tscircuit/rack-actuator/README.md

# Rack actuator

A 3D-printable rack-and-pinion linear actuator with **NEMA17 or NEMA14 drive**, **six 625ZZ guide bearings**, compliant rack teeth, and an enclosure with M3 heat-set mounting inserts. Choose **40, 100 or 150 mm stroke**, with an enclosed rack or a shorter rear pass-through housing.

**[Open the interactive CAD viewer](https://flex17-compliant-linear-actuator.seveibar.chatgpt.site/)** · **[Try the shorter enclosure](https://flex17-compliant-linear-actuator.seveibar.chatgpt.site/?motor=nema17&stroke=40&enclosure=pass-through)** · **[Explore NEMA14](https://flex17-compliant-linear-actuator.seveibar.chatgpt.site/?motor=nema14&stroke=40&enclosure=enclosed)** · **[Download CAD](https://flex17-compliant-linear-actuator.seveibar.chatgpt.site/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)**

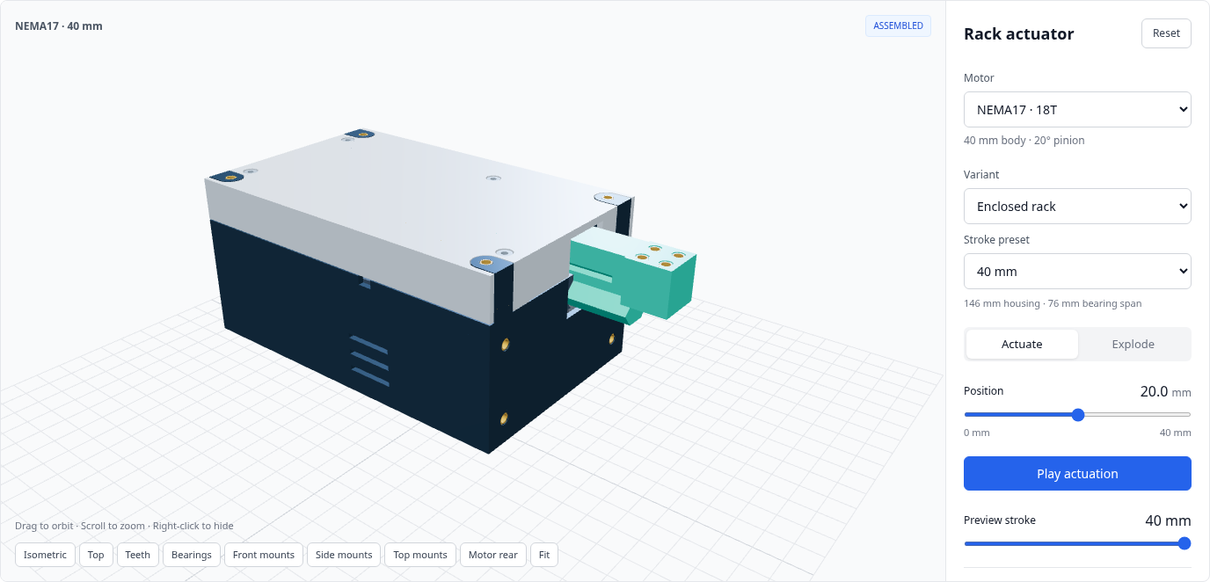
[picture p1: docs/images/viewer-overview.png]
NEMA17 actuator in the interactive viewer, with motor, enclosure variant, stroke and actuation controls (https://flex17-compliant-linear-actuator.seveibar.chatgpt.site/?motor=nema17&stroke=40&enclosure=enclosed)


The viewer provides actuation, a staged exploded assembly, right-click part hiding, mounting views, a resolution table, and preset-specific STEP/STL downloads. Screenshots and dimensions below show **CAD revision 24 at tooth module 2**. Click a screenshot to open its preset. Links select the motor, stroke and enclosure; camera angles, hidden parts and explosion stages are controlled inside the viewer.

[Models](#choose-a-model) · [Mechanism](#how-the-mechanism-works) · [Mounting](#mounting-the-module-and-its-load) · [Hardware & printing](#hardware-and-printing) · [Assembly](#assembly-and-service) · [Resolution](#resolution) · [Customize](#download-and-customize) · [Validation](#validation-and-practical-limits)

## Experimental worm drive

A separate **NEMA17 / NEMA14 worm family** is available at **40, 100 and 150 mm stroke** in the [worm viewer](https://flex17-compliant-linear-actuator.seveibar.chatgpt.site/experiments/worm-rack/). The worm now fits directly on the unchanged motor shaft position. A lowered tooth strip on a ribbed rack spine eliminates both spur gears and one worm bearing. The remaining end support uses an M5 insert and bolt through a captured 625ZZ bearing.

The **flat enclosure has the same dimensions, mounting-hole coordinates and mounting planes as the matching fully enclosed spur preset**. The worm contacts the underside of its matched compliant rack, retaining the guide profile and output mount. The motor body projects through the rear for back-face/controller access; its projection is listed separately in the viewer. These remain unprinted prototypes. See the [preset details, assembly sequence, source and checks](experiments/worm-rack/README.md). All twelve spur presets and both worm tooth styles use the axial NEMA17 output plate.

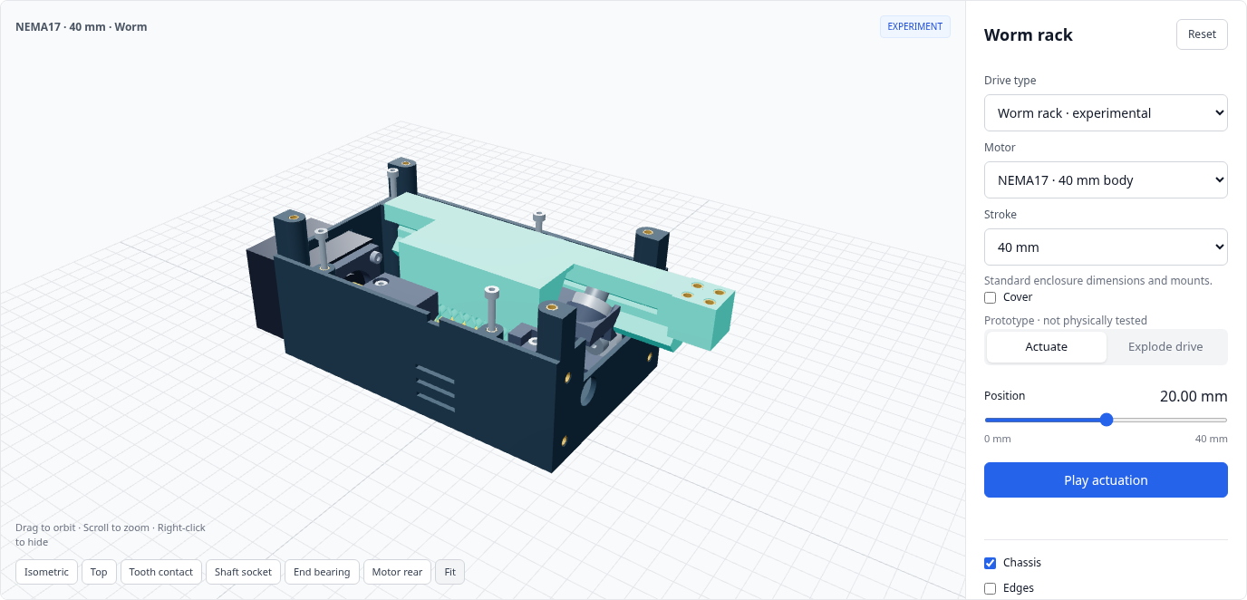
[picture p2: docs/images/worm-overview.png]
Enclosed NEMA17 40 mm worm-drive prototype with compatible mounting interfaces (https://flex17-compliant-linear-actuator.seveibar.chatgpt.site/experiments/worm-rack/)


## Lead-screw experiments

Both lead-screw families use a hollow carriage, two bearing stations and one four-bolt adjustable lower bearing carrier. The 40 mm printed-screw stroke supports 1×, 2× and 4× output widths. The 120 mm printed-screw stroke and both T8 lengths are 1× only. All have individual STL downloads and an exploded assembly.

- [Printed Ø20 mm screw](https://flex17-compliant-linear-actuator.seveibar.chatgpt.site/experiments/printed-leadscrew/?travel=120): select **40 or 120 mm travel**. Two threaded carriage bands stay engaged throughout travel, with the screw contained inside the retracted carriage. [Build details](experiments/printed-leadscrew/README.md).
- [T8×8 screw](https://flex17-compliant-linear-actuator.seveibar.chatgpt.site/experiments/t8-leadscrew/): select **100 or 300 mm purchased screw length**, providing 70 or 230 mm standard-drive travel. The 100 mm rod offers 1×/2×/4× widths. A selectable **6805 Z-axis support** uses a captured second brass nut and provides 44 / 204 mm travel for 100 / 300 mm rods. The 300 mm models have 80 mm between guide-bearing stations. [Build details](experiments/t8-leadscrew/README.md).

Both have windowed lids and a uniform 31 mm mounting grid on the output plate, lid and base. Output widths are 42/104/168 mm; the 2× plate is wider to retain a centered NEMA17 square. Both base and lid grids extend the same 31 mm alignment toward their exit edges. The 120 mm printed-screw version has 16 base and 14 lid insert seats; the 300 mm T8 has 22 on each face. Short versions retain 10/20/30 seats per face for 1×/2×/4× widths. Rounded side and floor windows are applied after all features. A single coordinated pattern preserves at least 6 mm between neighboring windows and protects the motor foot, bearing supports, adjustment shelves and mounting seats. Wider plates can mount along the host length: all eight 2× holes, or at least ten of twelve 4× holes in either of two offset positions. Longer grids also support the forward outer pair, allowing all twelve holes in the forward position. These external mounts use **short Ø4.6 × 4 mm M3 heat-set inserts**, with Ø4 mm printed pilots. Lid seats pass through; base seats below structural feet retain backing. Install lid inserts from above and base inserts from below. External side mounting bosses and holes have been removed. The shared lower carrier still uses four M5 inserts. Its support blocks rise just 1 mm above the Z=20 mm side rails with 1 mm, 45-degree top chamfers, remaining 3.5 mm below the original tall bumps; the bearing seats, split axles and mounting positions are retained. The fixed bearing supports extend down to Z=28 mm, flush with the adjustment-bolt shelves, filling the former 4 mm recess. Print fit and structural performance require physical testing.

## Choose a model

### Independent 6805 bearing support

The [6805 support prototype](https://flex17-compliant-linear-actuator.seveibar.chatgpt.site/experiments/bearing-supported-screw/) assembles a NEMA17, a flat 4 mm wall, an open bearing holder and the existing 40 mm-travel printed screw with an added bearing ring. Revision 3 keeps the 30.3 mm projection and motor-facing bearing recess, adding four exposed mounting flanges and side windows for loading the M3 screws. The 31 mm NEMA17 pattern and existing screw lengths are retained. The screw passes through the bearing and holder from the motor side, with its shoulder contacting the inner race. There is no separate cap, circlip or spacer. This supports thrust toward the screw tip; reverse retention relies on the coupling. Existing actuator geometry is unchanged. The viewer includes a section, corrected staged explosion and three printable STLs. [Build notes](dist/experiments/bearing-supported-screw/README.txt), [CAD source](experiments/bearing-supported-screw/model.py) and [assembly checks](experiments/bearing-supported-screw/check_assembly.py) cover fits and sampled clearances; PETG creep and vibration retention require physical testing.

All twelve combinations are generated and available to view and download:

| Motor | Stroke | Enclosed rack | Rear pass-through |
| --- | --- | --- | --- |
| NEMA17 | 40 mm | [View / download](https://flex17-compliant-linear-actuator.seveibar.chatgpt.site/?motor=nema17&stroke=40&enclosure=enclosed) | [View / download](https://flex17-compliant-linear-actuator.seveibar.chatgpt.site/?motor=nema17&stroke=40&enclosure=pass-through) |
| NEMA17 | 100 mm | [View / download](https://flex17-compliant-linear-actuator.seveibar.chatgpt.site/?motor=nema17&stroke=100&enclosure=enclosed) | [View / download](https://flex17-compliant-linear-actuator.seveibar.chatgpt.site/?motor=nema17&stroke=100&enclosure=pass-through) |
| NEMA17 | 150 mm | [View / download](https://flex17-compliant-linear-actuator.seveibar.chatgpt.site/?motor=nema17&stroke=150&enclosure=enclosed) | [View / download](https://flex17-compliant-linear-actuator.seveibar.chatgpt.site/?motor=nema17&stroke=150&enclosure=pass-through) |
| NEMA14 | 40 mm | [View / download](https://flex17-compliant-linear-actuator.seveibar.chatgpt.site/?motor=nema14&stroke=40&enclosure=enclosed) | [View / download](https://flex17-compliant-linear-actuator.seveibar.chatgpt.site/?motor=nema14&stroke=40&enclosure=pass-through) |
| NEMA14 | 100 mm | [View / download](https://flex17-compliant-linear-actuator.seveibar.chatgpt.site/?motor=nema14&stroke=100&enclosure=enclosed) | [View / download](https://flex17-compliant-linear-actuator.seveibar.chatgpt.site/?motor=nema14&stroke=100&enclosure=pass-through) |
| NEMA14 | 150 mm | [View / download](https://flex17-compliant-linear-actuator.seveibar.chatgpt.site/?motor=nema14&stroke=150&enclosure=enclosed) | [View / download](https://flex17-compliant-linear-actuator.seveibar.chatgpt.site/?motor=nema14&stroke=150&enclosure=pass-through) |

### Enclosure options

**Enclosed rack** keeps the toothed section inside the housing throughout normal travel; the smooth output tongue extends through the front. **Rear pass-through** removes the rear storage chamber and adds an opening for the rack and teeth. Both retain the same motor position, bearing stations, rack and usable stroke.

| Stroke | Enclosed housing length | Pass-through housing length | Length saved | Maximum rear projection |
| --- | --- | --- | --- | --- |
| 40 mm | 146 mm | 125 mm | 21 mm | 17 mm |
| 100 mm | 256 mm | 175 mm | 81 mm | 77 mm |
| 150 mm | 356 mm | 225 mm | 131 mm | 127 mm |

Housing width is **90.8 mm for NEMA17** and **84.8 mm for NEMA14**. The shorter housing still needs clearance for the rack's full swept travel. At module 2, its rear opening spans Y=15…41 mm and Z=−10…22 mm in CAD coordinates.

The following two screenshots use the **same 150 mm pass-through model and camera**, first fully retracted, then fully extended:

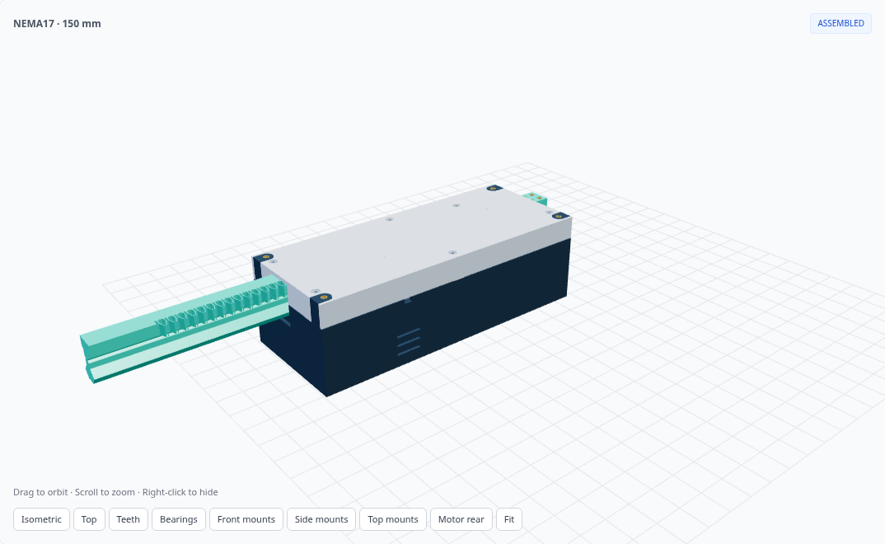
[picture p3: docs/images/pass-through-retracted.png]
150 mm pass-through actuator fully retracted, with the rack projecting through the rear of its 225 mm housing (https://flex17-compliant-linear-actuator.seveibar.chatgpt.site/?motor=nema17&stroke=150&enclosure=pass-through)


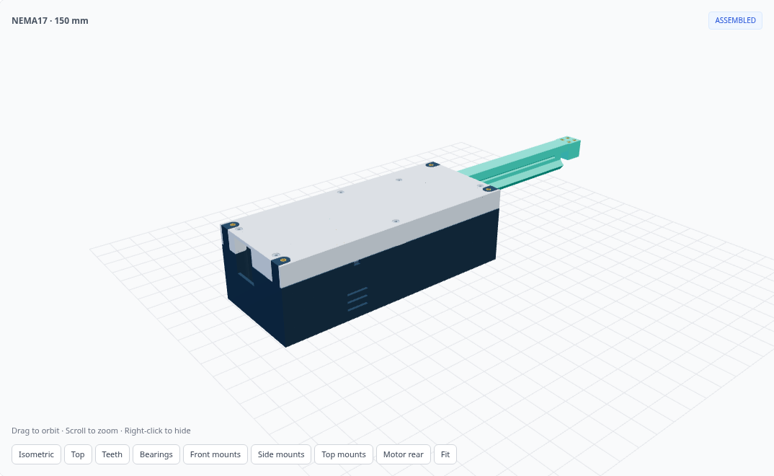
[picture p4: docs/images/pass-through-extended.png]
The same 150 mm pass-through actuator fully extended, with the output now projecting from the front (https://flex17-compliant-linear-actuator.seveibar.chatgpt.site/?motor=nema17&stroke=150&enclosure=pass-through)


[Try the 150 mm pass-through model](https://flex17-compliant-linear-actuator.seveibar.chatgpt.site/?motor=nema17&stroke=150&enclosure=pass-through) and drag **Position** between 0 and 150 mm, or select **Play actuation**.

Use the complete bundle for the selected motor, stroke and enclosure. Tray, lid, mounting coordinates and chassis clearance slots can differ between variants.

### NEMA17 versus NEMA14

| Default | NEMA17 | NEMA14 |
| --- | --- | --- |
| Reference motor body | 42 × 42 × 40 mm | 35.2 × 35.2 × 34 mm |
| Motor mounting pitch | 31 mm | 26 mm |
| Pinion | 18 teeth, 20° pressure angle | 14 teeth, 25° pressure angle |
| Tooth module | 2 mm | 2 mm |
| Travel per revolution | 113.097 mm | 87.965 mm |
| Housing width | 90.8 mm | 84.8 mm |

These are full-depth reference motors. The rear-mounted controller can remain outside the enclosure; its exact dimensions are not modeled. Verify the shaft, pilot and mounting dimensions of the motor you plan to use. The NEMA14 pinion gives a smaller commanded travel increment; motor torque and achievable accuracy depend on the actual hardware.

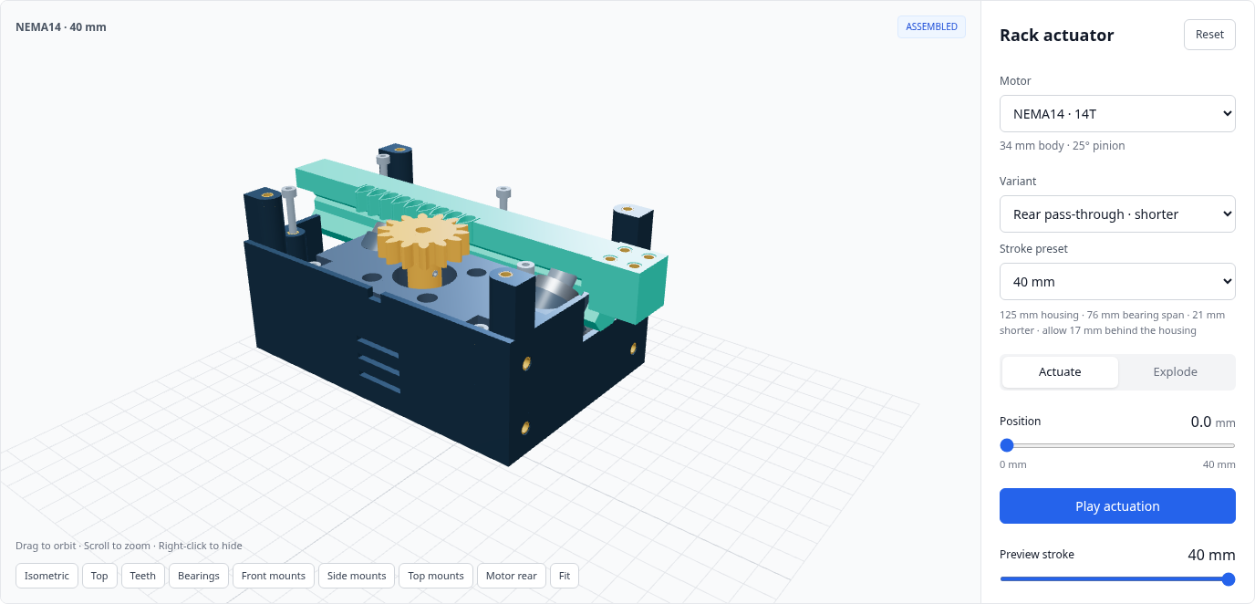
[picture p5: docs/images/nema14-viewer.png]
NEMA14 40 mm pass-through actuator with its cover hidden to reveal the smaller pinion and bearing mechanism (https://flex17-compliant-linear-actuator.seveibar.chatgpt.site/?motor=nema14&stroke=40&enclosure=pass-through)


## How the mechanism works

The pinion drives a compliant rack guided by two sets of three bearings. The chassis incorporates the motor mounting land and lower-bearing flexures. Five printed parts make up the module: **chassis, rack, pinion, tray and lid**.

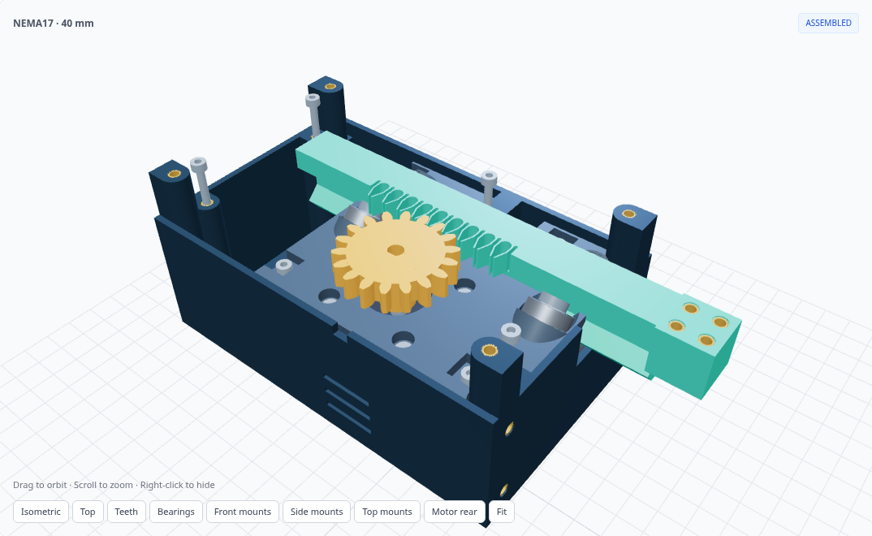
[picture p6: docs/images/mechanism.png]
NEMA17 actuator with the lid hidden, showing the pinion, compliant rack, bearing stations and chassis mounting screws (https://flex17-compliant-linear-actuator.seveibar.chatgpt.site/?motor=nema17&stroke=40&enclosure=enclosed)


### Compliant rack teeth

The rack teeth are oversized by **0.10 mm per flank** by default, so the flexible tooth walls preload the mesh. Circular reliefs blend tangentially into the slots, avoiding sharp internal corners where the teeth bend. There are no separate internal tooth fingers. The defaults use 0.60 mm walls and an 8 mm tooth face.

The design is intended to reduce backlash through elastic contact. It does not establish a measured backlash, force or fatigue rating. Tooth size is configurable through `--tooth-module`.

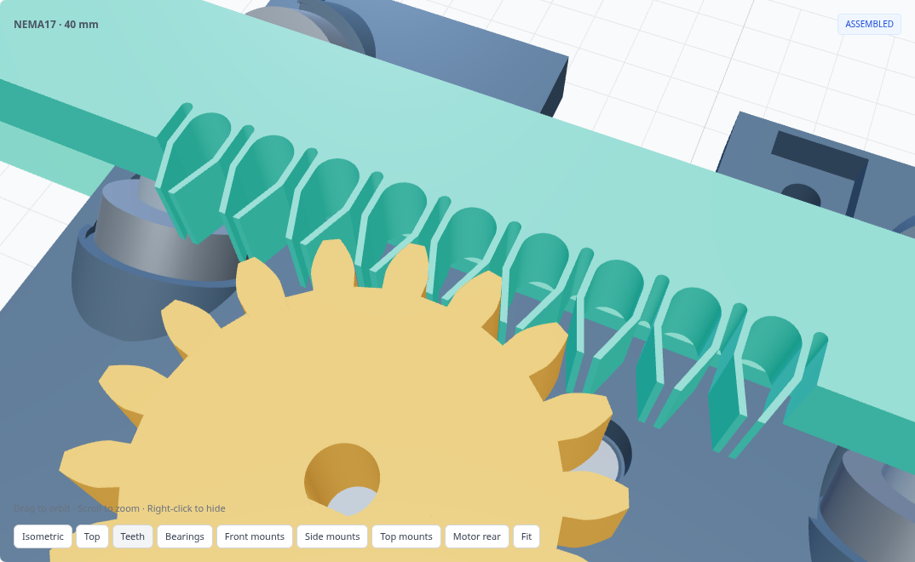
[picture p7: docs/images/compliant-teeth.png]
Close view of the pinion meshing with oversized compliant rack teeth and rounded relief cuts (https://flex17-compliant-linear-actuator.seveibar.chatgpt.site/?motor=nema17&stroke=40&enclosure=enclosed)


[Inspect the teeth in 3D](https://flex17-compliant-linear-actuator.seveibar.chatgpt.site/?motor=nema17&stroke=40&enclosure=enclosed) using the **Teeth** view. The tooth concept is inspired by [seveibar/compliant-spur-gear](https://github.com/seveibar/compliant-spur-gear).

### Bearing guidance and integral flexures

All six guide bearings are **625ZZ, 5 × 16 × 5 mm**. Four upper bearings sit at 45°; two lower bearings press upward from integral flexure floors. Recesses in the rack provide vertical support. The bearing layout constrains the rack while allowing translation along its travel axis.

The lower flexure is a single broad floor with a **14 mm free span**, **1.8 mm default thickness**, supported R1.2 wall blends and **2.3 mm nominal installed deflection**. The STL chassis is relaxed; the STEP assembly and viewer show the installed shape. CAD deformation is prescribed, not a calculated load/deflection curve.

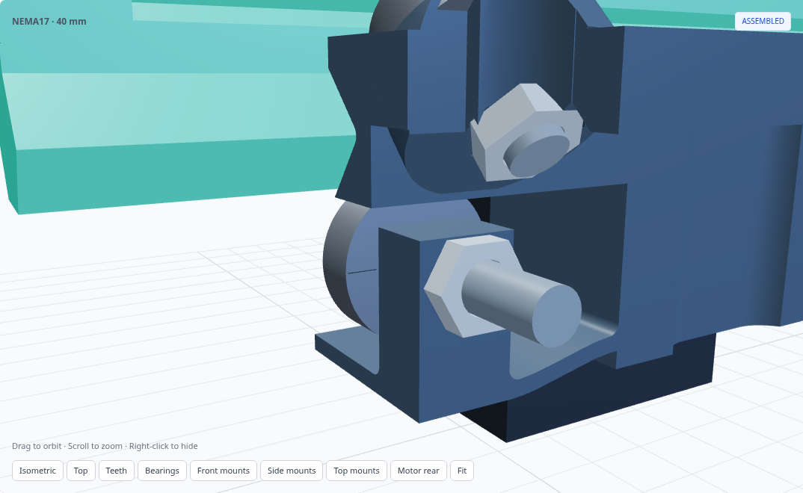
[picture p8: docs/images/bearing-flexure.png]
Close view of a bearing station, axle hardware and the integral lower-bearing flexure floor (https://flex17-compliant-linear-actuator.seveibar.chatgpt.site/?motor=nema17&stroke=40&enclosure=enclosed)


The motor stays at X=0 and the rear bearing station at X=−32 mm. The exit station is **13 mm behind the front face**, placing the bearing rim 5 mm behind the opening. The pinion is offset toward the rear bearing group.

| Stroke | Bearing station centers X | Bearing span | Rack print length |
| --- | --- | --- | --- |
| 40 mm | −32, 44 mm | 76 mm | 161.5 mm |
| 100 mm | −32, 94 mm | 126 mm | 271.5 mm |
| 150 mm | −32, 144 mm | 176 mm | 371.5 mm |

Nominal rack/chassis clearance is 1 mm. Bearing relief defaults to 0.8 mm and axle-head relief to 0.5 mm. Check actual printed and purchased hardware clearances; clamp bearing inner races without clamping the rotating outer races.

## Mounting the module and its load

M3 heat-set inserts default to **4.6 mm OD × 5 mm long**, with **4.2 mm printed pilot holes**. Qualify the pilot and installation temperature for your particular inserts and print material. Four inserts are provided on each of the following mounting faces:

| Face | Mounting pattern | Insert position |
| --- | --- | --- |
| Front / rack exit (+X) | Housing width − 18 mm by motor depth − 10 mm | 0.3 mm recessed |
| Side (+Y) | Housing length − 15 mm by motor depth − 10 mm | 0.3 mm recessed |
| Top (+Z) | Housing length − 15 mm by housing width − 15 mm | Flush in full-height tray posts |
| Moving output (+X, along travel) | NEMA17: 31 × 31 mm on a 42 × 42 × 8 mm end plate | 0.3 mm recessed |

The output pad is centered on the rack backbone. Its four insert pockets continue as **3.4 mm through-holes through the full 8 mm plate**. Either fit M3 inserts or skip them and use M3 through-bolts with washers and nuts. Choose bolt length for the pad, attachment, washers and nut engagement. Use application-length screws with **3–5 mm insert engagement**: 3.3–5.3 mm penetration from recessed faces, or 3–5 mm from the flush top face. Use the selected preset's mounting metadata to lay out your fixture.

The fixed front face has four inserts outside the rack opening. A front fixture must clear the moving guide and the entire output pad at full retraction. At module 2, the minimum rectangular fixture opening spans the preset’s `frontFixtureOpeningYZ` metadata, including the end plate. Top fixtures load the full-height tray posts; remove them before opening the lid.

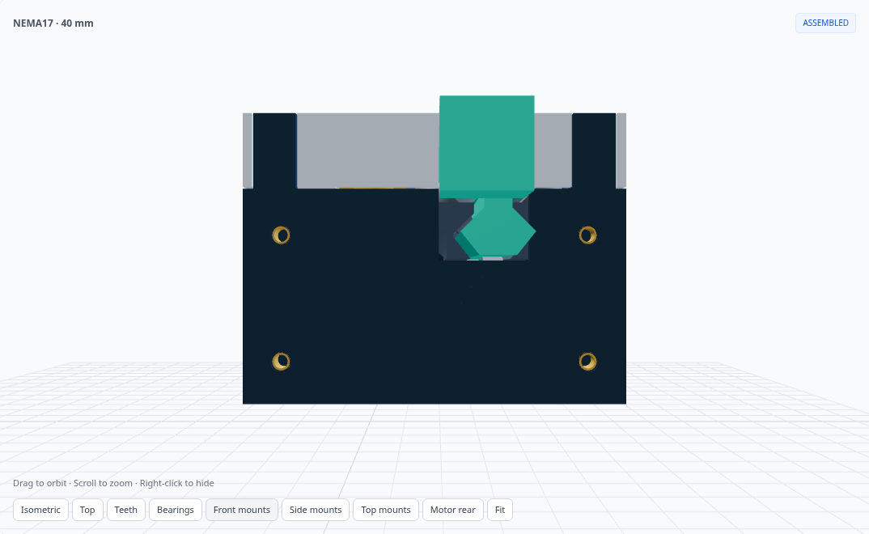
[picture p9: docs/images/front-mounts.png]
Front view of the enclosure mounting inserts and the moving rack output (https://flex17-compliant-linear-actuator.seveibar.chatgpt.site/?motor=nema17&stroke=40&enclosure=enclosed)


[Open the mounting views](https://flex17-compliant-linear-actuator.seveibar.chatgpt.site/?motor=nema17&stroke=40&enclosure=enclosed) and select **Front mounts**, **Side mounts** or **Top mounts**.

### Motor and driver access

The motor mounting land is integral to the chassis. The pinion has a **5.30 mm D bore** for a nominal 5 mm shaft with a 0.5 mm-deep flat. Its M3×4 flat-point set screw acts normal to the shaft flat; tap the 2.5 mm pilot M3.

The motor rear projects 4 mm beyond the housing. Leave room behind it for the driver, wiring, cooling and removal. The screenshot shows the reference motor, not a modeled controller board.

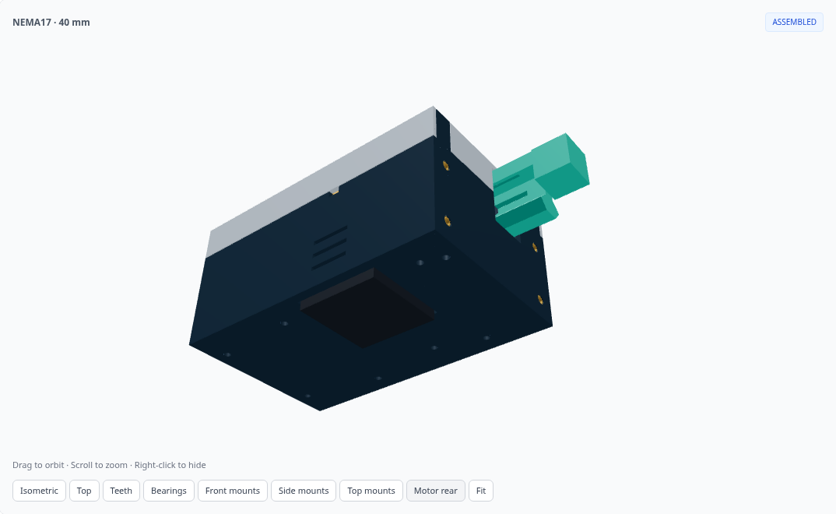
[picture p10: docs/images/motor-rear.png]
View beneath the enclosure showing the exposed rear of the reference motor and clearance for a rear-mounted driver (https://flex17-compliant-linear-actuator.seveibar.chatgpt.site/?motor=nema17&stroke=40&enclosure=enclosed)


## Hardware and printing

Every download bundle contains a preset-specific `bill-of-materials.json` and `configuration.json`.

| Common hardware | Quantity / specification |
| --- | --- |
| Stepper motor | 1 × matching NEMA17 or NEMA14 motor |
| Guide bearings | 6 × 625ZZ, 5 × 16 × 5 mm |
| Upper bearing axles | 4 × M5×16 socket screws |
| Lower bearing axles | 2 × M5×25 socket screws |
| Bearing nuts | 6 × thin M5 nuts, modeled 2.7 mm thick |
| Inner-race washers | 6 × 0.3 mm thick, 7.5 mm OD |
| Motor screws | 4 × M3×12 countersunk |
| Pinion set screw | 1 × M3×4 flat point |
| Lid screws | M3×20 socket; quantity below |
| Chassis screws | Front M3×10 / rear M3×16 socket; quantities below |
| External mounting screws | Application-specific lengths; observe insert engagement |

| Stroke / enclosure | Total M3 inserts, including output | Lid screws | Front / rear chassis screws |
| --- | --- | --- | --- |
| 40 mm, either enclosure | 24 | 4 | 2 / 2 |
| 100 mm, enclosed | 28 | 6 | 3 / 3 |
| 100 mm, pass-through | 26 | 4 | 3 / 3 |
| 150 mm, either enclosure | 28 | 6 | 3 / 3 |

Rear chassis inserts sit **6 mm below the standoff tops**, clearing the neighboring M5 hardware. Use the specified M3×16 rear screws; the front screws are M3×10.

| Printed part | Orientation / important detail |
| --- | --- |
| Chassis | Y normal to the bed, keeping the XZ flexure bending plane within the layers; use local supports at passages where needed |
| Rack | End plate projects past both long faces; use supports beneath the rack, or print on the plate if build height and layer strength permit. Keep tooth reliefs clear. |
| Pinion | Gear face down; finish the set-screw pilot with an M3 tap |
| Tray | Outer floor down |
| Lid | Roof down |

Parts are single-piece. Check your printer's build volume, especially the 271.5 and 371.5 mm racks. A shorter enclosure does not shorten the printed rack. See [printing and assembly instructions](README.txt) for insert depths, clearances and the detailed assembly sequence.

## Assembly and service

[Open the assembly viewer](https://flex17-compliant-linear-actuator.seveibar.chatgpt.site/?motor=nema17&stroke=40&enclosure=enclosed) and select **Explode**. The slider separates components in stages, including lifting and parking axle hardware and moving the chassis before lowering the tray.

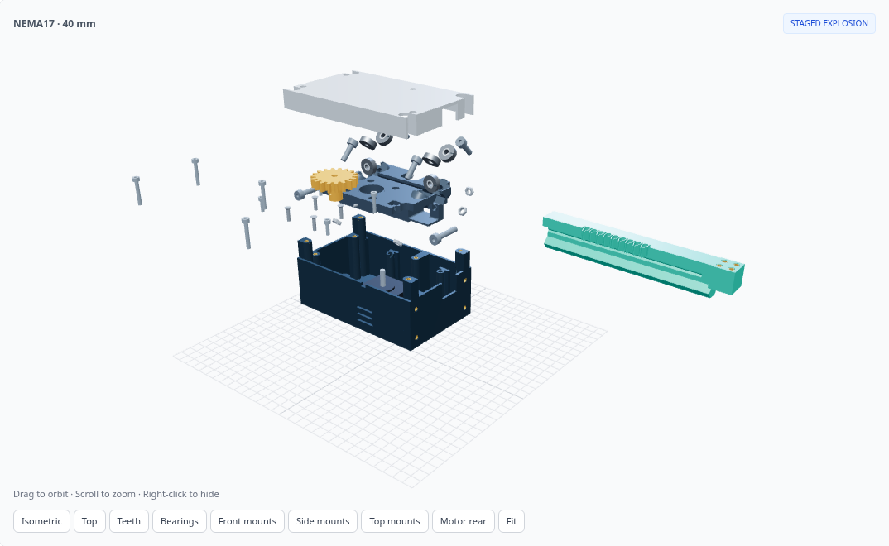
[picture p11: docs/images/exploded-assembly.png]
Exploded actuator showing the rack, enclosure, chassis, bearings and fasteners along staged clearance paths (https://flex17-compliant-linear-actuator.seveibar.chatgpt.site/?motor=nema17&stroke=40&enclosure=enclosed)


A practical assembly outline:

1. Print and clean the five parts. Clear tooth reliefs and bearing pockets; prepare the pinion's set-screw thread.
2. Install the tray heat-set inserts and, if using them, the output-pad inserts before closing access to their pockets.
3. Fit the lower bearings with their axles backed out 10 mm and nuts held loose. Start the chassis 6 mm above and 10 mm behind its seated position, slide it forward, lower it, then advance the axles and tighten the nuts.
4. Install the front and rear chassis screws. Fit the motor and motor screws before the upper rollers and axles.
5. Fit the pinion and set screw. Insert the rack from the output side, square end first, with the motor free to turn; support the spring seats as needed.
6. Confirm all six bearings turn without rubbing, fit the lid, then attach the external fixture and load. Check full travel at low speed before applying load.

For service, remove external fixtures and load first. Follow the exploded sequence: lid and rack, pinion, upper axle hardware and rollers, motor, chassis screws, partial lower-axle withdrawal, chassis lift/slide, tray, then the remaining bearing hardware. The animation illustrates clearance paths; it does not model gravity or workholding. [README.txt](README.txt) gives the complete sequence.

## Resolution

For a 1.8° motor with 200 full steps per revolution:

```text
travel per command = π × tooth module × pinion tooth count / (200 × microstep factor)
```

| Setting | NEMA17, 18T: mm/command | NEMA14, 14T: mm/command |
| --- | --- | --- |
| Full step | 0.565487 | 0.439823 |
| Half step | 0.282743 | 0.219911 |
| 1/4 step | 0.141372 | 0.109956 |
| 1/8 step | 0.070686 | 0.054978 |
| 1/16 step | 0.035343 | 0.027489 |

These are nominal command increments, not measured positioning accuracy. Stroke and enclosure choice do not change the drive ratio. Match the calculation to the actual motor's full-step angle.

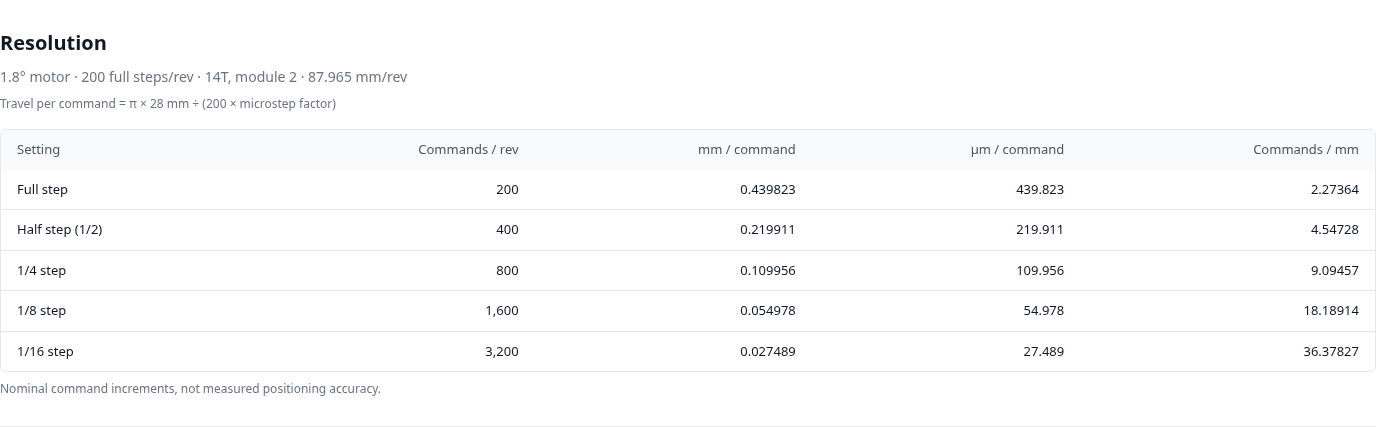
[picture p12: docs/images/resolution.png]
NEMA14 resolution table in the viewer showing full, half, quarter, eighth and sixteenth-step command increments (https://flex17-compliant-linear-actuator.seveibar.chatgpt.site/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)


[View the NEMA17 resolution table](https://flex17-compliant-linear-actuator.seveibar.chatgpt.site/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) · [View the NEMA14 resolution table](https://flex17-compliant-linear-actuator.seveibar.chatgpt.site/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)

## Download and customize

The easiest route is to [open the site](https://flex17-compliant-linear-actuator.seveibar.chatgpt.site/), choose **Motor**, **Variant** and **Stroke preset**, then use **Downloads → CAD bundle**. Each bundle includes:

- Five printable STL parts. STEP export is currently omitted from the hosted bundles.
- Parametric CadQuery source and the selected configuration.
- Hardware quantities, printing/assembly instructions and licenses.
- Collision, guide and service-clearance reports.

The **Configure** panel exports JSON parameters or a CadQuery command. Tooth module, stroke, housing length and motor body depth are separate parameters. The viewer displays generated module-2 presets; custom values require regeneration.

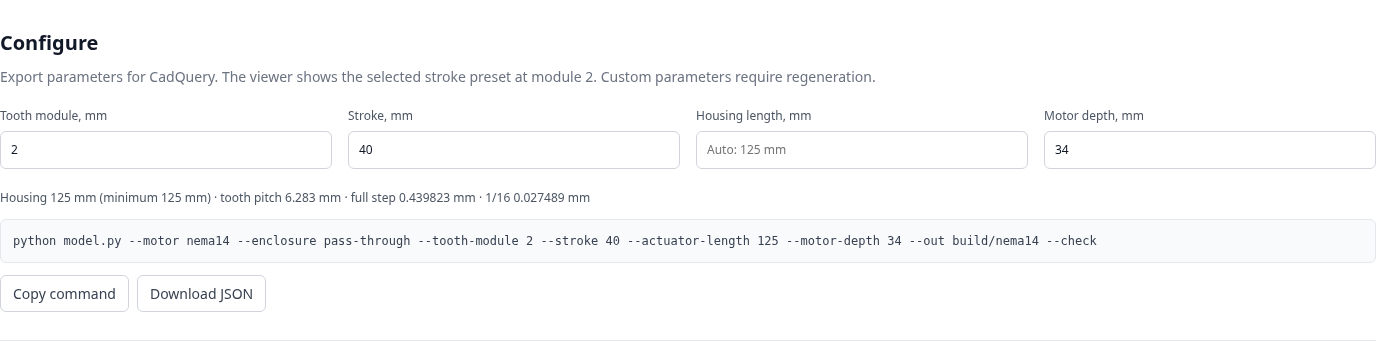
[picture p13: docs/images/configuration.png]
Configuration panel for tooth module, stroke, housing length and motor depth, with JSON export and a CadQuery command (https://flex17-compliant-linear-actuator.seveibar.chatgpt.site/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)


[Open the configurator](https://flex17-compliant-linear-actuator.seveibar.chatgpt.site/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) · [NEMA17 downloads](https://flex17-compliant-linear-actuator.seveibar.chatgpt.site/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) · [NEMA14 downloads](https://flex17-compliant-linear-actuator.seveibar.chatgpt.site/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)

### Run the viewer locally

The generated models are committed, so previewing them does not require CadQuery:

```sh
git clone https://github.com/tscircuit/rack-actuator.git
cd rack-actuator
python -m http.server 8000 --directory dist
```

Open `http://localhost:8000`. Use an HTTP server rather than opening `index.html` directly, because the viewer loads model files with `fetch`.

### Generate a custom actuator

Use Python 3.12 and CadQuery 2.7.0:

```sh
pip install -r requirements.txt

# Example: NEMA14, 100 mm stroke, shorter rear pass-through housing
python model.py --motor nema14 --stroke 100 --enclosure pass-through --out build/custom --check

# Or use the configuration exported by the site / included in a bundle
python model.py --config path/to/configuration.json --out build/custom --check
```

Explicit CLI arguments override JSON values. Housing length defaults to the calculated minimum for the selected stroke, tooth size and enclosure. The CLI name for housing length is `--actuator-length`.

| Parameter | Supported values / default |
| --- | --- |
| `--motor` | `nema17` (default) or `nema14` |
| `--enclosure` | `enclosed` (default) or `pass-through` |
| `--stroke` | 20–150 mm; default 40 |
| `--tooth-module` | 1.5–2.5 mm; default 2 |
| `--actuator-length` | Calculated minimum through 2000 mm |
| `--motor-depth` | 32–60 mm; defaults 40 / 34 for NEMA17 / NEMA14 |
| `--insert-od`, `--insert-length`, `--insert-pilot` | Defaults 4.6 / 5 / 4.2 mm |
| `--spring-preload` | 0.1–2.5 mm; default 2.3 |
| `--spring-thickness` | 1.6–2.2 mm; default 1.8 |
| `--bearing-clearance`, `--hardware-clearance` | Defaults 0.8 / 0.5 mm |
| `--rack-backbone-width` | 14.5–18 mm; default 16 |
| `--preload` | Tooth oversize per flank; default 0.10 mm |

Regenerate, check and package all twelve presets from the repository root:

```sh
python build_presets.py --jobs 4
python check_flexure_service.py --jobs 4
python check_lid_screw_parking.py --all
python package_designs.py
```

The axial NEMA17 output update replaces only the former mounting pad. Exact solid differences confirm unchanged guide and tooth geometry. Continuous conservative swept bounds check the larger plate through full travel and every assembly translation stage; previous mechanism checks are retained with their original report hashes. New output-hole and insertion-access probes and watertight STL checks accompany each preset. The interface is the four-hole NEMA17 pattern; no motor pilot or shaft bore is added.

Build caching is tied to source, motor, stroke and enclosure. Use a distinct output directory for custom models to keep the supplied presets intact.

## Validation and practical limits

The supplied presets have completed sampled travel, explosion and service checks with no unexpected intersections. The reports distinguish intentional elastic tooth contact and heat-set insert interference from unwanted solid intersections.

| Report / check | What it covers |
| --- | --- |
| `validation.json` | Assembled part pairs; 41 travel positions; guide contacts; nominal tooth mesh; insert access, annular backing and output through-holes; flexure/hardware clearances; staged explosion |
| `flexure-service-validation.json` | Bearing and enclosure service paths from 38–100% explosion, with translation increments at most 0.5 mm |
| `lid-screw-clearance.json` | Continuous swept envelopes for removing lid screws and separating them from subsequent assembly motion |
| `check_guide_constraints.py` | Bearing guidance constraints |

Enclosure/fastener paths are sampled at no more than 0.5 mm translation increments. Core explosion checks include 1% slider intervals, stage boundaries/midpoints and bearing-release transitions. Reports record source hashes and explain any retained results where geometry and checking logic are unchanged.

These checks do not replace a physical tolerance, side-load or fatigue test. The flexure's restoring force, recovery and lifetime have not been rated; the compliant teeth have no measured backlash/load rating. There is no axial hard stop or downward flexure stop. Use controller travel limits and validate the print material and actual hardware before loading the module.

[Open validation reports on the site](https://flex17-compliant-linear-actuator.seveibar.chatgpt.site/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) · [Detailed assembly instructions](README.txt)

## Repository map

| Path | Contents |
| --- | --- |
| [model.py](model.py) | Parametric CadQuery geometry, exports and checks |
| [build_presets.py](build_presets.py) | Generates the two motors × three strokes × two enclosures |
| [package_designs.py](package_designs.py) | Packages downloads and creates the preset manifest |
| [check_flexure_service.py](check_flexure_service.py) | Dense bearing-removal/service checks |
| [check_lid_screw_parking.py](check_lid_screw_parking.py) | Lid-screw clearance proof |
| [dist/](dist/) | Static viewer, generated meshes and CAD downloads |
| [dist/presets.json](dist/presets.json) | Paths and metadata for all twelve presets |
| [README.txt](README.txt) | Detailed printing, insert installation and assembly instructions |
| [docs/images/](docs/images/) | Screenshots of the revision 24 viewer and mechanism |

## License and credits

MIT; see [LICENSE](LICENSE). The compliant tooth principle is inspired by [seveibar/compliant-spur-gear](https://github.com/seveibar/compliant-spur-gear). Its license is included in the CAD bundles.

For Site packaging after regenerating spur presets, run `python scripts/prune-bundled-stls.py`. It verifies loose STL files against the existing ZIP bundles before removing duplicate payloads; individual viewer downloads extract the same STL bytes from those bundles.

All six supported lead-screw configurations are rebuilt and checked with the bundled generator and validator. Reports retain their exact SHA-256 hashes. Checks cover the full bearing sweep, motion and assembly clearance, insert access, mounting grids, preserved base supports and connected printable solids.

Lead-screw bearing axles use tapered, rounded-root relief slots and clearance behind the inner-race seats. The retained 6.4 mm heads and extended 30° tips are unchanged. Assembly checks distinguish undeformed head contact from unexpected collisions; physical snap force and fatigue remain unmeasured.

The lead-screw bases use filled motor feet, 45-degree side-window roofs and bottom access below the adjustment shelves. Inspect the actual 40 mm, 1x printed-screw base slice at [the support preview](https://flex17-compliant-linear-actuator.seveibar.chatgpt.site/experiments/printed-leadscrew/slice/). Reproduction profiles and G-code extraction are in `experiments/printed-leadscrew/slicing/`.

The 1x T8 and printed-screw output plates have two underside openings for fitting the lower M3 mounting bolts from inside. Fully extend the carriage for access. The front 31 mm pattern, 8 mm flange thickness and bearing tracks are retained. Use the viewer’s **Bolt access** view to inspect them.

The 2×/4× printed-screw plates now have bolt-access openings for every repeated output pattern. The front bearing station moves inward 14 mm to protect the full rolling surfaces (60 mm between stations); overall size and 40 mm extension are unchanged. Use the updated wide base, carrier, lid and carriage together. The previously published 1× geometry and example base slice are unchanged.

The two lid mounts beside the motor now grow from continuous gussets, rooted 2 mm into the motor wall. Their undersides slope at least 45° above horizontal in both the forward and outward directions, replacing the hanging blocks and thin tabs. The existing lid holes and 68 mm assembly height are retained; only the base STL changes for this revision. Print with the base floor on the bed. The public slice preview uses the updated 40 mm, 1× printed-screw base.
