tscircuit/rack-actuator/docs/images/output-mount.png

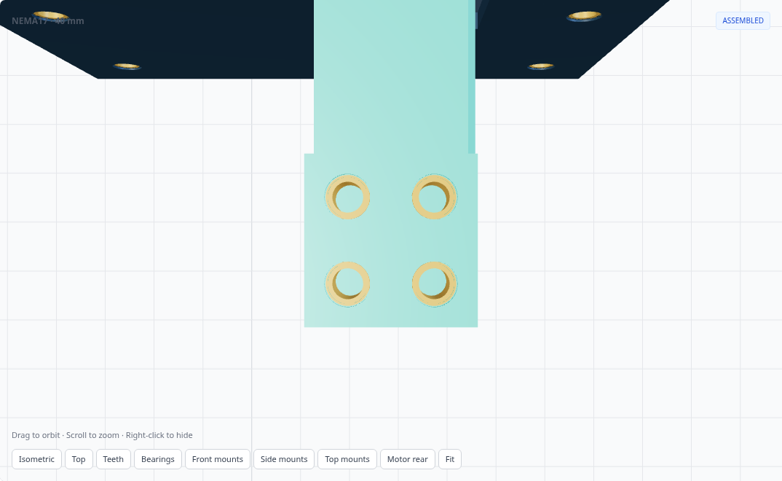
docs/images/output-mount.png
