tscircuit/rack-actuator/docs/images/output-through-holes.png

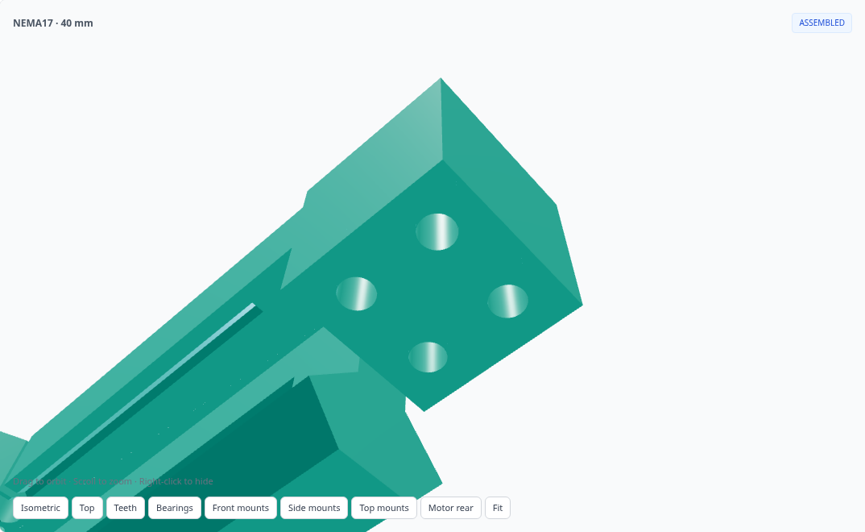
docs/images/output-through-holes.png
