tscircuit/rack-actuator/docs/images/worm-nema14-150.png

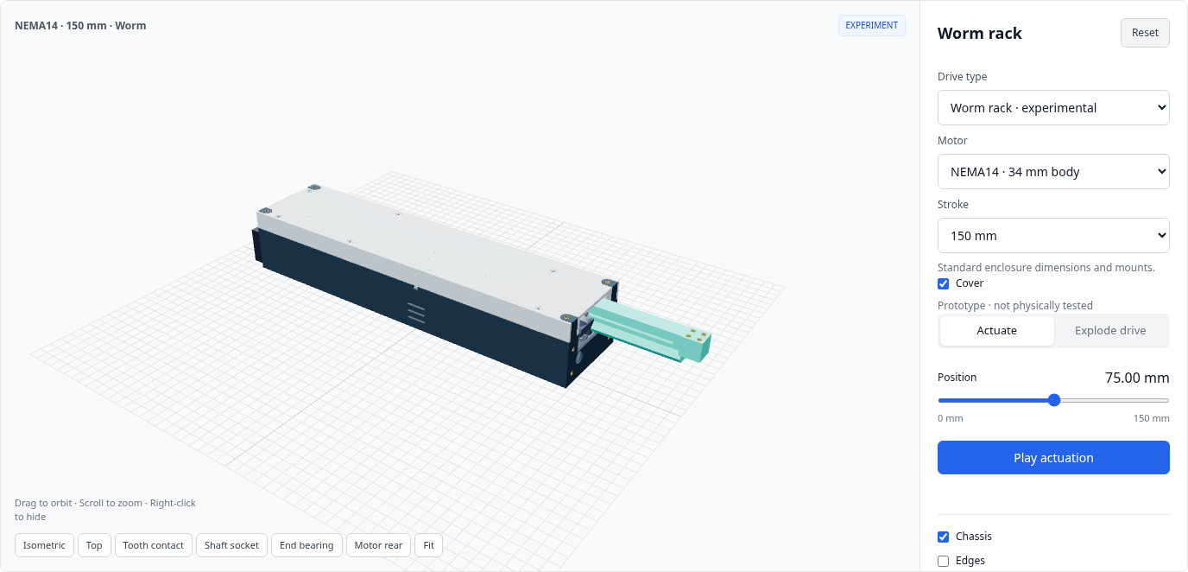
docs/images/worm-nema14-150.png
