tscircuit/rack-actuator/dist/experiments/printed-leadscrew/slice/base-40mm-petg.gcode.3mf

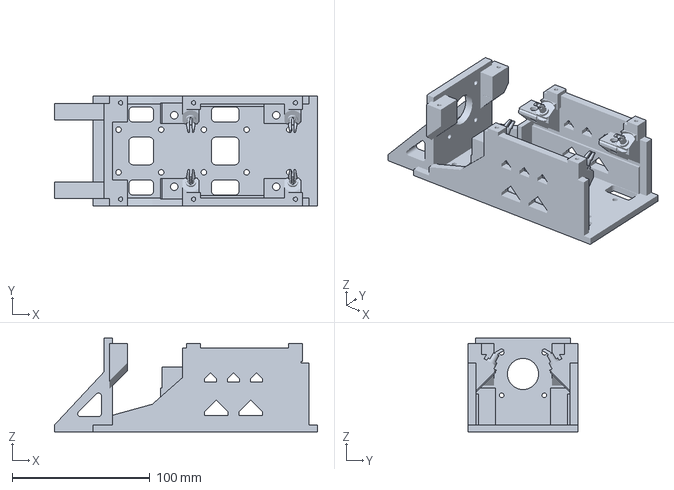
[picture p17: CAD file, 2026-11-10]
dist/experiments/printed-leadscrew/slice/base-40mm-petg.gcode.3mf
191.0 x 80.0 x 68.0 mm
