tscircuit/rack-actuator/dist/experiments/adjustable-rack/spur/README.md

# NEMA17 40 mm spur — screw-adjusted guide variant

Separate prototype. Original flexure chassis remains available.

- Six 625ZZ guide bearings (5 × 16 × 5 mm), on six integral PETG snap axles.
- One rigid carrier holds both lower bearings, 76 mm apart. Four M3×20 socket screws pull the carrier upward; four M3 heat-set inserts (4.6 mm OD × 5 mm long) provide its threads. Pilot diameter 4.2 mm. Confirm the pilot on a coupon for your insert and printer.
- 1 mm release travel, guided carrier edges, four-point adjustment. Tighten evenly in small increments until play disappears and the rack still slides freely. No torque or load rating is established.
- Each axle has a 4.8 mm shank, split 1.2 mm relief with rounded root, and two tapered retaining ears (5.6 mm maximum width). Bearing support land Ø7.8 mm touches the inner ring; the outer ring has a recessed seat.
- Retain the 42 mm output plate with axial 31 × 31 mm NEMA17 mounting pattern.
- Worm shaft bearing and its axial fastener remain unchanged; the six rack-guide bearings use snap axles.

## Assembly

Follow the Assembly slider in reverse. Install heat-set inserts before placing the carrier. Snap guide bearings on while supporting the axle root; do not force a bearing if the printed ears cannot compress freely. Assemble carrier into the open-ended guides, then enclosure, motor/drive and rack. Fit the four adjustment screws and set them evenly after inserting the rack. Close the cover last. The worm's two rear support screws back out 8 mm and stay with the chassis during removal. To service, loosen/release the carrier before withdrawing the rack. The animation shows the split pins compressing schematically; this is not a PETG stress simulation.

## Printing and scope

STLs are in millimeters, one mesh per printed part. Check orientation and supports in your slicer; keep support out of the split slots and bearing running surfaces. Validate snap fit with a test print before committing to the full chassis. PETG creep, pin fatigue, screw torque, loaded rigidity and service life have not been measured. The report describes sampled geometric checks and their limits.

Use this variant's chassis, carrier and enclosure tray together. Do not mix its tray with the earlier flexure chassis.
