tscircuit/rack-actuator/dist/experiments/t8-leadscrew/index.html

Actuator experimentsGitHub ↗ (https://github.com/tscircuit/rack-actuator)

NEMA17 · T8×8 · 100 mm screwPROTOTYPE

Loading lead-screw experiment…

Drag to orbit · Scroll to zoom · Right-click for part actions

IsometricTopMounting gridBearing trianglesOutput mountBolt accessMotor lid mountsBearing carrierThreads / nutMotor couplingBearing axlesFit

# T8 lead screw

Reset

100 mm screw · 70 mm usable extension

T8 screw lengthDrive support

Uses a captured second T8 nut and a holder reinforced on both sides. Four M3×40 screws fasten the holder and base directly into the NEMA17 motor. No separate holder bolts or locknuts. Reprint the Z base and holder; other printed parts and travel are unchanged. Check that your motor accepts 5.7 mm screw engagement.

Width variant (100 mm screw)

View

Extension beyond base exit0.0 mm

0 mm70 mm

Play actuation

0.00 screw revolutions from retracted

Assembly separation100%

AssembleExplode all

Drag to follow the sequence: lid fasteners, lid, carriage, drive and retained-head bearings, then the shared carrier. The split heads flex inward for bearing installation. The viewer shows that interference without simulated bending; physical head passage is unverified. The screw rotates during carriage withdrawal.

Show base Show lid Transparent lid Transparent carriage Edges

Part

HideDownload STLShow all

### Shared bearing carrier

Carrier take-upContact

Tighten the four top-entry M5×40 socket-head bolts evenly to raise both lower bearings together. The slider shows 1 mm of rigid take-up to contact; preload and carrier tilt are not simulated.

Two bearing stations: six guide bearings at 1×, eight at wider widths. The shared carrier uses four M5 inserts. Its bearing-support blocks rise just 1 mm above the side rails, with 45° chamfers for local reinforcement. Aligned short M3 insert patterns are on the lid and underside of the base; there are no external side mounting holes.

70mmExtension past base exit

8mm / revT8×8 · four starts

6625ZZTwo bearing triangles

40mmBetween bearing stations

## T8 drive with two bearing triangles

This version is sized by its standard 100 mm T8×8 lead screw. The NEMA17 drives it through a rigid coupling, with 8 mm of the rod inside the coupling and a brass flange nut inside the hollow carriage. Usable extension is 70 mm (8.75 revolutions), with full nut engagement and 4.5 mm of screw remaining beyond the nut at full extension. Both bearing triangles support the carriage throughout travel and remain 40 mm apart. The screw stays inside the carriage when retracted. The base is 159×80 mm; overall length including the motor is 191 mm retracted and 261 mm extended.

One rigid adjustable carrier

All lower bearings attach to one printed carrier with two side rails and cross-braces. Four M5×40 bolts engage M5 heat-set inserts to pull it upward. The bearings press onto split integral axles. The carriage running faces are smooth, without raised side rails to catch small bearing misalignment. All bearing seats retain Ø7.4 mm inner-ring lands and 2 mm outer-ring relief. Solid Ø4.8 mm journals retain the 6.4 mm heads and extended 30° bent tips. Tapered relief cuts have rounded roots; clearance behind the bearing seats frees the prongs. Test snap fit on the actual PETG print.

Structural lid and mounting

The base and lid continue their original 31 mm square grid toward their exit edges, with ribs connecting every insert seat around the cutouts. Cutouts run after all features are complete. One coordinated pattern replaces overlapping floor windows, keeping at least 6 mm between neighboring windows and protecting the motor foot, bearing supports and mounting seats. Their first NEMA17 square is centered 26 mm ahead of the motor. The output plates use the same pitch and retain their centered NEMA17 pattern; the 2× plate is 104 mm wide. Use short M3 heat-set inserts, Ø4.6×4 mm, in Ø4 mm pilots. Lid seats pass through; base seats retain backing where they lie beneath structural feet. Maximum screw entry is 4 mm into the lid or 5 mm into the base. The old side bosses, side holes and external lid mounting holes are removed. Rounded lid windows retain a continuous perimeter and ribs around the mounting and fixing rows. The lid remains 4 mm thick and the assembly stays 68 mm high. Six structural lid fasteners remain separate from the external insert patterns.

Print files

The standard drive has four printed parts: base with split axles, hollow carriage, shared bearing carrier and lid. The Z variant adds the 6805 holder and captured-nut drive hub. The fixed bearing-support blocks and adjustment shelves have 45° undersides to eliminate trapped supports. All parts have individual STL downloads and a source bundle. Geometry checks do not establish load capacity, backlash or print-fit tolerances.

## Geometry checks

Loading check report…

Hardware meshes are fit references. Carrier adjustment shows rigid take-up to contact, not preload force. The viewer and STL retain the same split head geometry. Undeformed head/bore interference is recorded in the assembly report. Insertion force and deformation are not simulated. Test bearing fit, insertion force, retention and creep before use.

Detailed geometry report

## Repeating NEMA17 mounting grid

The output plate, lid and base use a uniform 31 mm square hole grid. The 2× output plate is now 104 mm wide so it keeps a centered NEMA17 square. Both faces keep the same origin and continue in 31 mm steps toward the exit. The 120 mm printed-screw version has eight base rows and seven lid rows; the 300 mm T8 has eleven rows on each. Shorter designs retain five rows.

To mount a wider plate along a narrow host’s length, center a 2× plate at 57 or 88 mm ahead of the motor and use all eight holes. A 4× plate uses the same two positions and ten of its twelve holes; the remaining outer pair overhangs the original five-row grid. Longer bases and lids also include the forward outer pair. Wide variants are offered for 100 mm T8 screws and 40 mm printed-screw travel. The 300 mm T8 has 80 mm between bearing stations and reduced travel.

## Print files & source

Downloads match the selected screw length and width. The bundle contains all printed-part STLs, CAD source, configuration and check report. No STEP download is required.

Updated base: sloped bearing supports replace the flat shelves. Use four M5×40 socket-head adjustment screws with the existing washers and inserts. The carrier, lid and carriage are unchanged.

Download 100 mm T8 screw bundle ↓Build notes ↓

Printed parts include the base, carriage, shared rigid bearing carrier and lid. Right-click hardware to download its reference STL.

T8×8 · 100 / 300 mm screw lengths · selectable drive supportSpur actuatorWorm experiment

HideIsolateDownload STLShow all
