tscircuit/rack-actuator/dist/experiments/adjustable-rack/index.html

Rack actuatorGitHub ↗ (https://github.com/tscircuit/rack-actuator)

Loading adjustable rack…

Loading CAD…

FitIsometricAdjustment screwsShow all

# Adjustable rack

NEMA17 · 40 mm travel · axial NEMA17 output plate

DriveBearing support

Rack teeth

ViewTravel 20 mmPlay actuationCarrier adjustment

Assembly separation

Cover Edges

One rigid carrier supports both lower bearings. Four M3 screws pull it upward into the rack; loosen evenly before withdrawing the rack. Heat-set inserts carry the adjustment threads.

Six integral split PETG axles retain the guide bearings. Bearing seats touch the inner races only. Pin strain, load capacity and PETG creep require a physical test.

## Downloads and checks

Checking model report…

STL bundleGeometry reportAssembly notes

Right-click a printed part to download its STL, isolate it, or mark points. Existing flexure versions remain separate.

Hide partIsolateDownload STLShow all parts
