tscircuit/rack-actuator/dist/experiments/worm-rack/index.html

Rack actuatorGitHub ↗ (https://github.com/tscircuit/rack-actuator/tree/main/experiments/worm-rack)

NEMA17 · 40 mm · WormEXPERIMENT

Loading experiment…

Drag to orbit · Scroll to zoom · Right-click for part actions

IsometricTopTooth contactShaft socketEnd bearingMotor rearFit

Bearing support

# Worm rack

Reset

Drive typeRack teeth

MotorStroke

Standard enclosure mounts. NEMA17 output plate: 31 × 31 mm M3 pattern, bolts parallel to travel.

Cover

Upper motor flange: use the matching updated chassis and tray. Motor bolts: upper pair from above (lid/rack off), lower pair from underneath. Compact 2.5 mm hex key (8 mm short reach, 40 mm long leg). Bolts withdraw 11 mm, then lift out above or below. Use Explode drive to replay removal and insertion.

Prototype · not physically tested

ActuateExplode drive

Position20.0 mm

0 mm40 mm

Play actuation

Separation0%

Turn the worm to wind the rack out, remove the end bolt and spacer, then withdraw motor and worm together.

Remove motor boltsInsert motor bolts

Assembly sequence

ChassisEdges

Parts

Hide selectedShow all

40mmStroke

6.283mm/revSingle-start lead

m2 / 20°Matching axial profile

7 × 625ZZ6 guide + 1 worm support

## Feasibility test

The worm fits directly onto the motor D shaft. Its far end uses one M5 insert, M5×16 bolt and captured 625ZZ bearing. The tooth strip sits lower on a ribbed rack spine. The output retains four Ø3.4 mm through-holes for optional M3 inserts or through-bolts.

Loading geometry checks…

Fine-mesh collision screening with OCC solid-intersection confirmation at sampled positions. The reinforced compliant teeth use thicker walls and rounded closed tips, with geometric preload. The solid variant has no tooth relief slots and uses flank clearance instead. Strength, elastic deformation, wear and axial-bearing life are not simulated. Do not assume self-locking. Motor controllers remain outside the enclosure and are not modeled.

Detailed check report

## Mounting

Enclosure:

Mounting coordinates · mm

## Resolution

Setting | mm / command | µm / command

Command increments use the worm lead at 1:1 motor speed; they are not measured accuracy or repeatability.

## Experimental files

The selected rack download matches the teeth dropdown. The full bundle contains both rack variants, matching coupons, source and reports.

Download selected rack STLDownload tooth-fit coupon

STL & source bundleBuild notesCadQuery source (bundle)

Worm and spur racks share the axial NEMA17 output interface.

Worm rack feasibility prototypeBack to spur actuator

Hide partIsolateDownload STLShow all parts
