tscircuit/rack-actuator/(commit log)

2026-10-16 Add revision 09 NEMA17 rack actuator CAD and viewer
    [01_Six_roller_chassis.stl, 03_Involute_pinion_18T.stl, 04_Beveled_compliant_rack.stl, 05_Eccentric_bushing_-23.0.stl, 05_Eccentric_bushing_23.0.stl, FLEX17.step]
2026-10-30 Replace eccentric bearing preload with four-leaf spring cartridges
    [01_Six_roller_chassis.stl, 04_Beveled_compliant_rack.stl, 05_Eccentric_bushing_-23.0.stl, 05_Eccentric_bushing_23.0.stl, 05_Leaf_spring_cartridge_left.stl, 05_Leaf_spring_cartridge_right.stl, FLEX17.step]
2026-10-30 Integrate broad bearing spring floors into the chassis
    [01_Integral_spring_chassis.stl, 01_Six_roller_chassis.stl, 05_Leaf_spring_cartridge_left.stl, 05_Leaf_spring_cartridge_right.stl, FLEX17.step]
2026-10-30 Extend spring floors to the walls and remove the rigid lower deck
    [01_Integral_spring_chassis.stl, FLEX17.step]
2026-10-30 Increase flexure preload and clearances; add compact NEMA14 variant
    [01_Integral_spring_chassis.stl, 03_Involute_pinion_14T.stl, 04_Beveled_compliant_rack.stl, FLEX14.step, FLEX17.step]
2026-10-30 Widen rack, reduce and bound head relief, and remove end chamfer
    [04_Beveled_compliant_rack.stl, FLEX14.step, FLEX17.step]
2026-11-02 Add configurable enclosed NEMA17 and NEMA14 actuators
    [04_Beveled_compliant_rack.stl, 05_Mounting_enclosure_tray.stl, 06_Removable_enclosure_cover.stl, FLEX14.step, FLEX17.step]
2026-11-02 Add M3 heat-set enclosure, top mounts and stroke presets
    [01_Integral_spring_chassis.stl, 03_Involute_pinion_14T.stl, 03_Involute_pinion_18T.stl, 04_Beveled_compliant_rack.stl, 05_Mounting_enclosure_tray.stl, 06_Removable_enclosure_cover.stl, FLEX14.step, FLEX17.step]
2026-11-02 Compress large STEP downloads for the hosting asset budget
    [FLEX14.step, FLEX17.step]
2026-11-03 Move bearing stations toward the enclosure exit and center the drive
    [01_Integral_spring_chassis.stl, 04_Beveled_compliant_rack.stl, 05_Mounting_enclosure_tray.stl, 06_Removable_enclosure_cover.stl, FLEX14.step, FLEX17.step]
2026-11-03 Replace slotted enclosure tabs with flush M3 heat-set side mounts
    [05_Mounting_enclosure_tray.stl, FLEX14.step, FLEX17.step]
2026-11-03 Add four M3 heat-set inserts to the moving rack output pad
    [04_Beveled_compliant_rack.stl, FLEX14.step, FLEX17.step]
2026-11-03 Add front M3 mounts, opposed-leaf flexures and compact layouts up to 150 mm
    [01_Integral_spring_chassis.stl, 03_Involute_pinion_14T.stl, 03_Involute_pinion_18T.stl, 04_Beveled_compliant_rack.stl, 05_Mounting_enclosure_tray.stl, 06_Removable_enclosure_cover.stl, FLEX14.step, FLEX17.step]
2026-11-03 Restore thicker broad flexures and move exit bearings forward in smaller single housing
    [01_Integral_spring_chassis.stl, 03_Involute_pinion_14T.stl, 03_Involute_pinion_18T.stl, 04_Beveled_compliant_rack.stl, 05_Mounting_enclosure_tray.stl, 06_Removable_enclosure_cover.stl, FLEX14.step, FLEX17.step]
2026-11-03 Center four-insert output mount on the moving rack
    [04_Beveled_compliant_rack.stl, FLEX14.step, FLEX17.step]
2026-11-03 Add rear chassis standoffs, recessed M3 inserts and mounting screws
    [05_Mounting_enclosure_tray.stl, 06_Removable_enclosure_cover.stl, FLEX14.step, FLEX17.step]
2026-11-03 Add rear pass-through enclosure variants: source batch 1/10
    [FLEX17.step]
2026-11-03 Add rear pass-through enclosure variants: source batch 2/10
    [FLEX14.step]
2026-11-03 Add rear pass-through enclosure variants: source batch 3/10
    [01_Integral_spring_chassis.stl, 03_Involute_pinion_14T.stl, 04_Beveled_compliant_rack.stl, 05_Mounting_enclosure_tray.stl, 06_Removable_enclosure_cover.stl, FLEX14.step]
2026-11-03 Add rear pass-through enclosure variants: source batch 4/10
    [01_Integral_spring_chassis.stl, 03_Involute_pinion_14T.stl, 04_Beveled_compliant_rack.stl, 05_Mounting_enclosure_tray.stl, 06_Removable_enclosure_cover.stl, FLEX14.step]
2026-11-03 Add rear pass-through enclosure variants: source batch 5/10
    [01_Integral_spring_chassis.stl, 03_Involute_pinion_14T.stl, 04_Beveled_compliant_rack.stl, 05_Mounting_enclosure_tray.stl, 06_Removable_enclosure_cover.stl, FLEX14.step]
2026-11-03 Add rear pass-through enclosure variants: source batch 6/10
    [FLEX17.step]
2026-11-03 Add rear pass-through enclosure variants: source batch 7/10
    [01_Integral_spring_chassis.stl, 03_Involute_pinion_18T.stl, 04_Beveled_compliant_rack.stl, 05_Mounting_enclosure_tray.stl, 06_Removable_enclosure_cover.stl, FLEX17.step]
2026-11-03 Add rear pass-through enclosure variants: source batch 8/10
    [01_Integral_spring_chassis.stl, 03_Involute_pinion_18T.stl, 04_Beveled_compliant_rack.stl, 05_Mounting_enclosure_tray.stl, 06_Removable_enclosure_cover.stl, FLEX17.step]
2026-11-03 Add rear pass-through enclosure variants: source batch 9/10
    [01_Integral_spring_chassis.stl, 03_Involute_pinion_18T.stl, 04_Beveled_compliant_rack.stl, 05_Mounting_enclosure_tray.stl, 06_Removable_enclosure_cover.stl, FLEX17.step]
2026-11-03 Add rear pass-through enclosure variants: source batch 10/10
    [FLEX17.step]
2026-11-03 Expand README with illustrated actuator guide and live preset links
2026-11-03 Add isolated NEMA17 40 mm worm-to-compliant-rack experiment
    [bearing_keeper_-1.stl, bearing_keeper_1.stl, d-shaft_coupler.stl, matched_compliant_rack.stl, open_guide_fixture.stl, rack_mesh_coupon.stl, single-start_worm.stl, worm_motor_cartridge.stl]
2026-11-04 Allow optional M3 through-bolts in output mounts: assets 1/7
    [04_Beveled_compliant_rack.stl, FLEX17.step, matched_compliant_rack.stl]
2026-11-04 Allow optional M3 through-bolts in output mounts: assets 2/7
    [04_Beveled_compliant_rack.stl, FLEX14.step]
2026-11-04 Allow optional M3 through-bolts in output mounts: assets 3/7
    [04_Beveled_compliant_rack.stl, FLEX14.step]
2026-11-04 Allow optional M3 through-bolts in output mounts: assets 4/7
    [04_Beveled_compliant_rack.stl, FLEX14.step]
2026-11-04 Allow optional M3 through-bolts in output mounts: assets 5/7
    [04_Beveled_compliant_rack.stl, FLEX17.step]
2026-11-04 Allow optional M3 through-bolts in output mounts: assets 6/7
    [04_Beveled_compliant_rack.stl, FLEX17.step]
2026-11-04 Allow optional M3 through-bolts in output mounts: assets 7/7
    [FLEX17.step]
2026-11-04 Integrate direct-drive worm and M5 end-bearing support
    [bearing_keeper_-1.stl, bearing_keeper_1.stl, d-shaft_coupler.stl, integral_worm_chassis.stl, matched_compliant_rack.stl, one-piece_direct-drive_worm.stl, open_guide_fixture.stl, rack_mesh_coupon.stl]
2026-11-04 Add mount-compatible enclosed worm actuator family: assets 1/4
    [FLEX17.step, integral_worm_chassis.stl, matched_compliant_rack.stl, one-piece_direct-drive_worm.stl, rack_mesh_coupon.stl]
2026-11-04 Add mount-compatible enclosed worm actuator family: assets 2/4
2026-11-04 Add mount-compatible enclosed worm actuator family: assets 3/4
2026-11-04 Add mount-compatible enclosed worm actuator family: assets 4/4
    [FLEX14.step, FLEX17.step]
2026-11-04 Lower worm motor with dual M5 inserts and spur reduction: assets 1/5
2026-11-04 Lower worm motor with dual M5 inserts and spur reduction: assets 2/5
2026-11-04 Lower worm motor with dual M5 inserts and spur reduction: assets 3/5
2026-11-04 Lower worm motor with dual M5 inserts and spur reduction: assets 4/5
2026-11-04 Lower worm motor with dual M5 inserts and spur reduction: assets 5/5
2026-11-04 Direct-shaft worm with lowered compliant rack: assets 1/5
2026-11-04 Direct-shaft worm with lowered compliant rack: assets 2/5
2026-11-04 Direct-shaft worm with lowered compliant rack: assets 3/5
2026-11-04 Direct-shaft worm with lowered compliant rack: assets 4/5
2026-11-04 Direct-shaft worm with lowered compliant rack: assets 5/5
2026-11-04 Add per-part STL downloads to viewer context menus
2026-11-08 Sync current actuator designs and site
    Update CAD sources, STL downloads, validation reports, and viewer for the rack and lead-screw experiments. Preserve smaller base-floor mounting patterns on wider variants and add GitHub links to the page headers.
    Site source: f1b338e145494b5c2df506efe0c4607008886ff9
    [04_Beveled_compliant_rack.stl]
2026-11-08 Size T8 actuator around a standard 100 mm lead screw
    Derive 70 mm travel from the screw length and full nut engagement. Extend the carriage and relocate its bearing stations, preserving 40 mm spacing. Update staged assembly, dynamic travel controls, STL downloads, and CAD validation reports.
    Validated 141 travel positions, 106 assembly poses, nut engagement, mounting access, watertight STLs, and browser behavior.
    Site source: 5740bf4a8648ab6858d10197e76b204cc907513c
2026-11-08 Use a bolt-and-nut D-shaft clamp on printed lead screws
    Fit a 5 mm D shaft with a 4.5 mm flat-to-opposite measurement. Replace the plastic-thread clamp with an M3x12 bolt and an anti-rotation hex nut pocket, preserving motor-opening clearance. Update all three widths, STLs, assembly removal paths, coupling close-up, and fit checks.
    Validate motion, staged assembly, clamp insertion and nut retention, supplementary full-rotation clearance, and browser downloads.
    Site source: eb0eace4d7be9fa49b7f59eac6c0300c36d6b516
    [validate.py]
2026-11-08 Add 300 mm T8 and width variants; fill bearing axle reliefs
    Provide 100 mm and 300 mm T8 screws at 1x, 2x and 4x output widths, retaining nested base-floor and central NEMA17 patterns. Fill lead-screw bearing axle relief slots while preserving the 6.4 mm heads and 30-degree bent tips. Update all nine configurations and downloadable STL/source bundles.
    Validate seated clearance, full travel, mounting access, and staged assembly. Record forced head/bore contacts separately without claiming physical passage is verified. Browser checks cover selectors, motion, explosion, and STL downloads.
    Site source: 9904fdaed4b9bf3d4999a173671981da880a0df4
    [validate.py]
2026-11-08 Remove raised bearing rails from lead-screw carriages
    Leave smooth running faces on T8 and printed-screw carriages across all lengths and widths. Retain axle heads and existing base/carrier clearance channels so only the carriage needs reprinting. Regenerate all nine STL/source bundles and update the viewer and documentation.
    Verify the former rail regions are empty, running skins remain continuous, and bearing envelopes clear at nominal alignment and +/-1 mm axial displacement. Preserve full-travel and staged-assembly checks; reject unreachable floor-fastener pairs using conservative swept bounds. Check browser motion and carriage STL downloads.
    Site source: 258b1c72819adef5bbc729a9cced19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
    [validate.py]
2026-11-09 Add 120 mm printed-screw travel and nested M3 insert mounts
    Offer 40/120 mm printed-screw travel at 1x/2x/4x width. Extend the screw, hollow nose, bearing layout and disassembly path for full 120 mm travel. For both lead-screw families, lighten the lid, add matching nested NEMA17-width M3 insert patterns to the lid and floor just ahead of the motor, and remove external side bosses and holes. Use short 4 mm M3 inserts with open-bottom pilots.
    Regenerate and validate all 12 configurations, including motion, insert access, staged assembly, printable mesh integrity, thread engagement and full screw rotation. Verify browser selectors and downloaded STL bytes.
    Site source: 43b5e8deb82464af70d151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
    [validate.py]
2026-11-09 Remove duplicate hosted STL payloads to fit the Site size limit
    Serve individual spur-rack STLs through the existing ZIP extraction helper. Verify all 60 extracted files match their former loose copies byte-for-byte, retain all bundles, and include a safe pruning script for regenerated exports. Browser-check default and NEMA14 long pass-through context-menu downloads. No geometry changes.
    Site source: 2fbe355176a4ce1c8ac6b9f4867e6049ca659bb3
    [01_Integral_spring_chassis.stl, 03_Involute_pinion_14T.stl, 03_Involute_pinion_18T.stl, 04_Beveled_compliant_rack.stl, 05_Mounting_enclosure_tray.stl, 06_Removable_enclosure_cover.stl]
2026-11-09 Use a uniform NEMA17 mounting grid across lead-screw actuators
    Add a true 31 mm square grid to output plates and matching five-row lid/base insert patterns across both lead-screw families. Widen the 2x plate to 104 mm to retain a centered NEMA17 pattern; preserve bearing stations and the carriage running section. Provide 10/20/30 insert seats per host face and two longitudinal mounting positions for overhanging 4x plates. Move the front lid fixings clear of the grid and connect insert seats with continuous ribs. On the 120 mm printed-screw 2x variant, shift the rear adjustment-bolt pair and its support 6 mm rearward to preserve straight driver access; retain all bearing centers.
    Regenerate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
    [validate.py]
2026-11-09 Extend lid mounting grids and lighten lead-screw bases
    Continue the existing 31 mm lid grid toward the exit with protected insert ribs. Keep wider output variants only for the 40 mm printed-screw stroke; normalize retired width links to 1x and remove their generated assets. Add rounded floor and side windows while retaining previous pockets, mounting seats, motor feet, bearing supports and carrier adjustment shelves.
    Rebuild all six supported configurations. Verify connected watertight parts, support preservation, smaller base volume, insert access, full travel, exploded assembly and printed-screw rotation. Exercise width/travel selection, retired links, mounting-grid view, mobile layout an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
2026-11-09 Extend base mounts and remove recessed supports and fragile cutout webs
    Continue the existing 31 mm base grid to the last row with adequate edge clearance. The 120 mm printed-screw base now has 16 insert seats and the 300 mm T8 base has 22. Preserve floor ribs around the new seats and update mounting layouts, hardware counts, documentation and viewer metadata. Extend all four fixed bearing supports down by 4 mm to the Z=28 mm underside of the adjacent adjustment-bolt shelves, filling the recessed overhang beside each bolt. Verify the filled regions and carrier clearance. Apply all volume-reduction cutouts as final post-processing after features and functional clearances. Replace overlapping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
    [validate.py]
2026-11-09 Restore split bearing axles on both lead-screw families
    Restore tapered relief slots with rounded roots and clearance behind the inner-race seats. Preserve the 6.4 mm retaining heads and extended 30-degree tips. Rebuild all six configurations and verify open slots, connected prongs, bearing seating, travel, staged assembly and watertight print meshes. Update the viewer, STL bundles and assembly documentation.
    Site source: 9795a6d2155ab7c172f641b258b76ff9141c7fa3
    [validate.py]
2026-11-09 Improve base printability and add an actual slicer support preview
    Fill the motor-mount underside, use 45-degree pitched side-window roofs, and add four bottom support-removal openings beneath the bearing and adjustment shelves. Preserve bearing seats, carrier guides, insert patterns and motion clearance across all six lead-screw configurations. Add a before/after layer viewer generated from actual Bambu Studio P2S PETG toolpaths and a revised sliced 3MF download.
    Site source: c14f176e0a37bc5571855cebcd0c7a4eb1a06a1a
    [base-40mm-petg.gcode.3mf, machine.json]
2026-11-09 Add inside bolt access to 1x lead-screw output plates
    Add rounded underside openings behind the two obstructed lower mounting holes. Preserve the 31 mm NEMA17 pattern, full 8 mm flange and bearing-running faces. Validate M3x12 socket-head loading and a short hex-key route at full extension, plus installed bolt clearance through travel. Rebuild the four 1x T8 and printed-screw configurations; retain the wider variants unchanged. Add a dedicated Bolt access viewer angle and update STL bundles and instructions.
    Site source: aa56c60e002ac6098044fd0b3d29487c604ff025
    [validate.py]
2026-11-09 Provide inside bolt access on all lead-screw widths
    Add upper and lower output access pockets on the 2x and 4x printed-screw carriages. Move the front bearing station inward 14 mm, retaining 60 mm station spacing, the original actuator envelope and 40 mm extension. Rebuild matching base, carrier, lid and carriage; retain the printed screw and all 1x assets. Validate every output bolt and driver path, complete travel, rolling surfaces, mounting inserts and staged assembly. Expose the Bolt access view for wider plates and explain the matching-part requirement.
    Site source: ddd34ee4f3d1e14e6504f9b9d49145c4588cf644
2026-11-09 Brace motor-side lid mounts with printable gussets
    Replace hanging rear lid blocks and thin tabs with continuous gussets rooted into the motor wall, with 45-degree or steeper undersides. Preserve mounting positions, lid fit and overall dimensions across all six lead-screw configurations. Validate the retained gusset material and root after functional clearances and final cutouts. Rebuild base STLs and bundles and add a Motor lid mounts inspection view.
    Slice the 40 mm 1x base with the existing P2S Generic PETG profile. No support or interface paths remain at either revised lid mount; total support drops from 7.0 g to 4.2 g. Publish updated paths and sliced 3MF, plus the preceding slice for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
    [base-40mm-petg.gcode.3mf]
2026-11-10 Add independent 6805 bearing-supported screw prototype
    Add a 4 mm NEMA17 wall, open bearing holder, outer-race cap and an additive bearing journal/shoulder on the existing printed screw. Capture the inner race with a spacer and standard DIN 471 steel circlip. Preserve every existing actuator geometry file.
    Provide a separate interactive experiment with staged explosion, section view, point marking and five printable STLs. Validate additive-only changes, meshes, assembled and rotational clearances, tool access and 35 disassembly poses. Physical PETG/vibration retention remains untested.
    Site source: e4a387c12f2544f90aa565d45d4bdd360a7d16be
2026-11-10 Reverse the bearing holder recess and simplify the support assembly
    Shorten holder projection by 1 mm to 30.3 mm. Seat the 6805 from the motor-facing side, supporting the outer race on the forward lip. Remove the cap, circlip, spacer and cap hardware, including obsolete STL downloads. Adapt the additive screw ring while preserving the original D bore and coupling split.
    Correct the exploded sequence so the screw withdraws rearward through the bearing before the bearing leaves its rear recess. Clear the loading path between the posts and remove fragile counterbore webs. Add rear-recess inspection and regenerate three printable parts. Validate geometry, rear loading, tool access, sampled disa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
2026-11-10 Expose bearing-holder mounting screws on side-access flanges
    Replace the deep mounting posts with rounded 6 mm foot flanges and outboard support ribs. Add 9 mm side windows for direct M3x16 screw loading and short front driver ports, retaining the 31 mm motor pattern and 30.3 mm holder projection. Keep the wall, screw and other actuator geometry unchanged.
    Validate continuous lateral loading and axial seating envelopes for all four screws with 0.5 mm radial head allowance. Update the staged explosion to lift the screws and remove them sideways, regenerate the holder STL and bundle, and add a Mounting flanges inspection view.
    Site source: 23b09fa8bd1a8d2a405b8ff21be3ca12dddf8a4a
2026-11-10 Lower shared bearing-carrier shoulders to rail height
    Remove the 4.5 mm raised support blocks behind the lower bearings across both lead-screw families and all six current configurations. Retain the inner-race seats, split axles, bearing centers and M5 insert mounts. Only carrier STLs change.
    Verify removed-only support geometry, base clearance throughout adjustment, bearing face relief, retained axle roots, insert fit, carriage motion and exploded assembly. Rebuild viewers and source/STL bundles and preserve all other printable parts.
    Site source: 00854ece9a111bd6562ed53cfc31a33729988ddf
    [validate.py]
2026-11-10 Add low chamfered reinforcement behind carrier bearings
    Add 1 mm-high reinforcement with 45-degree top chamfers behind the lower bearings across both lead-screw families and all six current configurations. Keep them 3.5 mm below the original tall blocks. Retain the inner-race seats, split axles, bearing centers and M5 insert mounts. Only carrier STLs change.
    Verify bounded reinforcement geometry, base clearance throughout adjustment, bearing face relief, retained axle roots, insert fit, carriage motion and exploded assembly. Rebuild viewers and source/STL bundles and preserve all other printable parts.
    Site source: a5e32b8873949aa95f04cd050235526791e44cd5
    [validate.py]
2026-11-10 Add wide T8 actuators and optional 6805 Z-axis support
    Offer 1x, 2x and 4x widths for the 100 mm T8 rod, with standard drive or a separate 6805-supported drive. The supported drive uses a captured second brass T8 nut, a printed hub and accessible bolt/nut clamps. Verify axial abutments, bearing fit, screw loading, rotation, full travel and staged assembly.
    Double the 300 mm rod guide spacing to 80 mm, reducing standard travel to 230 mm. Supported travel is 44 mm for the 100 mm rod and 204 mm for the 300 mm rod. Remove the lab-stock label. Preserve the separate printed-screw and standalone 6805 experiments.
    Regenerate matched STL/source bundles, validate meshes and exercise selectors, downl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
2026-11-10 Eliminate trapped supports in lead-screw bearing bases
    Give upper bearing blocks, axle roots and adjustment shelves continuous 45-degree undersides. Raise the bolt seats and use four M5x40 ISO 4762 socket-head screws; retain all other printed parts and the original travel. Update staged bolt/washer removal.
    Verify zero support extrusion in all four bays through every layer of actual P2S PETG slices for printed 40 mm 1x and T8 100 mm 2x 6805 Z bases. Publish the updated interactive slice and 3MF. Regenerate all twelve matched STL bundles with geometry, travel, assembly and mesh checks.
    Site source: 57625c9d95106ebc8c984acb897186f99a1b23cd
    [base-40mm-petg.gcode.3mf]
2026-11-10 Rebuild both 6805 holders with outward mounting columns
    Use a continuous bearing seat and four full-depth outward columns with rear-loaded M3x45 through-bolts, washers and accessible front locknuts. Give the motor independent NEMA17 screws. Update the separate wall and all four T8 Z bases, preserving screw geometry, other printed parts and travel.
    Validate bearing load paths, bolt access, motion, staged assembly and printable meshes. Verify zero supports for the shared holder and zero trapped support paths in all four adjustment bays of a freshly sliced T8 Z base. Update downloads, hardware lists and assembly guidance. This remains an untested physical prototype.
    Site source: 9fc2a74363739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
2026-11-10 Share four NEMA17 screws with both 6805 holders
    Replace separate outboard holder bolts and locknuts with four M3x40 screws through the holder and wall into the motor on its 31 mm square pattern. Continuous left/right shells reinforce the bearing seat while leaving clamp access above and below. Recess T8 bolt heads to retain 5.7 mm nominal engagement through its thicker wall. Preserve travel and the screw/hub geometry.
    Update all four T8 Z configurations and the separate supported-screw experiment, including captured-bolt disassembly, clearance and load-path checks, STL/source downloads and hardware instructions. Actual PETG slicing verifies the holder and bearing-adjustment support regions.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
    [validate.py]
